wwerst/EE52/Rec_Feb28Notes.txt

Milestones for week:
1) DRAM PLD design and simulation
2) Schematic: Power circuitry
3) PCB: Power circuitry

Simulation:
1) Single read
2) single write
3) Back-to-back read or write
4) Refresh
5) 

10110111

10101000
