wwerst/EE52/Rec_Feb21Notes.txt

Milestones for week:
1) DRAM Timing (Read/Write/Refresh) (60 pts)
2) DRAM Schematic/PCB (40 pts)
3) Audio Software Diagram (30 pts)
