wwerst/EE52/Rec_Feb14Notes.txt

Milestones for week:
1) Timing: Audio
2) Block Diagram: DRAM
3) PCB: Audio, Ethernet

Audio timing:
TCLK freq,
