wwerst/EE52/Rec_Feb7Notes.txt

Milestones for week:
1) LCD Timing
2) Audio Schematic
3) Ethernet Schematic

cd600dp
wh2125a
