wwerst/EE52/WebPages/EE_CS 52 Project - ARM VoIP Telephone Software Interface Specification.html

# ARM VoIP Telephone Project Software Interface Specification (version 1)

## Function Descriptions

This document describes the interface between the software that will be supplied and the code that must be written. Since each system is different there must be a level of abstraction between the supplied software and the actual hardware. This document describes the functions, symbols, and data structures that implement that abstraction. Note that this document only describes the interface between the supplied software and the project's hardware and many more data structures and functions will exist in the code that implements the low-level hardware routines.

The supplied software should be called after all initialization is done. A function called main is defined globally. This function runs the system and will never return. The supplied code assumes the code section is called .text, and the data section is called .data.

For each part of the software system the symbols, data, and functions are given. The names must match exactly. The symbols should be defined by the implementor (student) in the file interfac.h. A template for this file is included in the distribution. The symbol values in the supplied file will need to be changed to match the implementation. The data and functions should be declared .global in the .s file in which they are defined. The functions must maintain the values of R4, R5, R6, R7, R8, R9, R10, R11, R12 (FP), R14 (LR), R15 (PC) and, of course, not mess with the stack pointer - R13 (SP).

## General

#### Symbols

DRAM_START | | starting address of the DRAM
MEMORY_SIZE | | number of IP addresses which can be stored in memory for later recall (typically 32)
SAMPLE_RATE | | number of audio samples per second (typically 8000)
MAC_ADDR_H | | upper 16-bits of the 48-bit MAC address for the ethernet controller
MAC_ADDR_L | | lower 32-bits of the 48-bit MAC address for the ethernet controller
ETHER_INTF | | the name of the ethernet interface to use (typically "et0")

#### Data

None

#### Functions

int elapsed_time(void)

Returns the number of milliseconds which have elapsed since the last time this function was called. Note that this may be zero if the function was recently called.

## Keypad/Switches

#### Symbols

KEY_0 | | keycode for the <0> key
KEY_1 | | keycode for the <1> key
KEY_2 | | keycode for the <2> key
KEY_3 | | keycode for the <3> key
KEY_4 | | keycode for the <4> key
KEY_5 | | keycode for the <5> key
KEY_6 | | keycode for the <6> key
KEY_7 | | keycode for the <7> key
KEY_8 | | keycode for the <8> key
KEY_9 | | keycode for the <9> key
KEY_ESC | | keycode for the <ESC> key
KEY_BACKSPACE | | keycode for the <Backspace> key
KEY_SEND | | keycode for the <Send> key
KEY_OFFHOOK | | keycode for the <Off Hook> key
KEY_ONHOOK | | keycode for the <On Hook> key
KEY_SET_IP | | keycode for the <Set IP> key
KEY_SET_SUBNET | | keycode for the <Set Subnet> key
KEY_SET_GATEWAY | | keycode for the <Set Gateway> key
KEY_MEM_SAVE | | keycode for the <Memory Save> key
KEY_MEM_RECALL | | keycode for the <Memory Recall> key
KEY_ILLEGAL | | illegal keycode, different from any valid keycode

#### Data

None

#### Functions

unsigned char key_available(void)

Returns TRUE (non-zero) if there is a valid key ready to be processed and FALSE (zero) otherwise.

int getkey(void)

Returns the keycode (as defined above (http://wolverine.caltech.edu/eecs52/projects/armvoip/swispec.htm#KeySymbols)) for the debounced key. This value must never be KEY_ILLEGAL (http://wolverine.caltech.edu/eecs52/projects/armvoip/swispec.htm#KEY_ILLEGAL). The function does not return until it has a valid key.

## Display

#### Symbols

STATUS_IDLE | | current status (for display) is Idle
STATUS_OFFHOOK | | current status (for display) is Off Hook
STATUS_RINGING | | current status (for display) is Ringing
STATUS_CONNECTING | | current status (for display) is Connecting
STATUS_CONNECTED | | current status (for display) is Connected
STATUS_SET_IP | | current status (for display) is Set IP
STATUS_SET_SUBNET | | current status (for display) is Set Subnet
STATUS_SET_GATEWAY | | current status (for display) is Set Gateway
STATUS_MEM_SAVE | | current status (for display) is Memory Save
STATUS_MEM_RECALL | | current status (for display) is Memory Recall
STATUS_RECALLED | | current status is a memory address was just recalled, otherwise status is like Idle
STATUS_ILLEGAL | | illegal status, different from any valid status

#### Data

None

#### Functions

void display_IP(unsigned long int)

Displays the passed IP address on the LCD/LED display. The passed IP address is in binary.

void display_memory_addr(unsigned int)

Displays the passed memory address on the LCD/LED display. The passed memory address is in binary and will range from 1 to MEMORY_SIZE (http://wolverine.caltech.edu/eecs52/projects/armvoip/swispec.htm#MEMORYSIZE).

void display_status(unsigned int)

Displays the passed status (as described above (http://wolverine.caltech.edu/eecs52/projects/armvoip/swispec.htm#StatusSymbols)) on the LCD/LED display. Note that some status values may also cause tones or other sounds to be output. The passed status will never be STATUS_ILLEGAL (http://wolverine.caltech.edu/eecs52/projects/armvoip/swispec.htm#STATUS_ILLEGAL).

## Audio Circuitry

#### Symbols

AUDIO_BUFLEN | | length of each audio buffer This symbol specifies the size of the buffers used for audio input and output.

#### Data

None

#### Functions

void call_start(short int *)

Begins recording the microphone data into the passed buffer (of length AUDIO_BUFLEN (http://wolverine.caltech.edu/eecs52/projects/armvoip/swispec.htm#AUDIOBUFLEN)). The first argument points to the first buffer in DRAM to be filled with data. Note that the actual storing of data is done under interrupt control and this function should return immediately after setting up for the call. After this function is called and the call has begun all future buffers for audio data will be supplied using the update_rx (http://wolverine.caltech.edu/eecs52/projects/armvoip/swispec.htm#updateRX) and update_tx (http://wolverine.caltech.edu/eecs52/projects/armvoip/swispec.htm#updateTX) functions. Note that an initial output buffer is not passed (the call has just started so there isn't one as yet).

void call_halt(void)

Immediately halts audio transmitting and receiving for the call.

unsigned char update_rx(short int *)

Returns TRUE (non-zero) if an update was needed and the passed pointer was used (meaning the pointer was stored and the buffer will be recorded into by the user's code). FALSE (zero) should be returned if the audio input routines have not finished filling either of the buffers they already have. The passed pointer indicates the next buffer (of length AUDIO_BUFLEN (http://wolverine.caltech.edu/eecs52/projects/armvoip/swispec.htm#AUDIOBUFLEN)) to be filled. If TRUE is returned another buffer will be allocated for recording and its address will be passed to update_rx the next time it is called. If FALSE is returned then the software assumes the buffer was not used and will pass the same buffer pointer on the next call to update_rx. The supplied software also assumes that the data is double buffered. That is, it assumes the user code has two buffer pointers stored, the one currently being recorded to and the next one to be recorded to.

unsigned char update_tx(short int *)

Returns TRUE (non-zero) if an update was needed and the passed pointer was used (meaning the pointer was stored and the buffer data will be played by the user's code). FALSE (zero) should be returned if the audio output routines are not ready for more data. The passed pointer indicates the next buffer (of length AUDIO_BUFLEN (http://wolverine.caltech.edu/eecs52/projects/armvoip/swispec.htm#AUDIOBUFLEN)) to be played. When TRUE is returned another buffer will be retrieved from DRAM (where it was put by the networking routines) for the next call to update_tx. If FALSE is returned then the software assumes the buffer was not used and will pass the same buffer pointer on the next call to update_tx. The supplied software also assumes that the data is double buffered. That is, it assumes the user code has two buffer pointers stored, the one currently being played from and the next one to be played from.

## Ethernet

#### Symbols

None

#### Data

None

#### Functions

char ether_init()

Initializes the ethernet interface. This function does all of the low-level initialization for the ethernet interface. After it returns the ethernet interface is ready for use. The function returns TRUE (non-zero) if there is no error initializing the interface and FALSE (zero) if there is an error.

char ether_transmit(struct pbuf *)

Transmits the packet pointed to by the passed pbuf chain over the ethernet interface. The argument points to the first pbuf in the chain. Note that there could be more than one pbuf in the chain. The function returns TRUE (non-zero) if there is no error and FALSE (zero) if there is an error.

char ether_rx_available()

Returns TRUE (non-zero) if there is received ethernet data available and FALSE (zero) otherwise.

struct pbuf *ether_receive()

Returns a pointer to the start of a pbuf chain containing a received internet packet. If there is no ethernet data currently available, the function returns NULL. If there is data available a chain of pbuf buffers is filled with the received data. Note that the function pbuf_alloc must be called in this function in order to get a pbuf chain for storing the data.

Last updated February 03, 2016 by glen@caltech.edu

copyright � 2006 - 2016, Glen George. All rights reserved. Reproduction of all or part of this work is permitted for educational or research use only, provided that this copyright notice is included in any copy.
