wwerst/EE52/SoftwareDiagrams.pdf

2/5/2017 | Preview

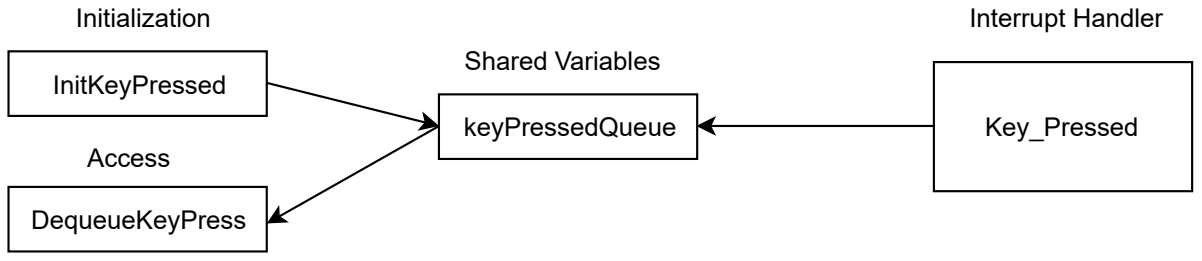
[picture p25: figure]
Key_Pressed; Interrupt Handler; keyPressedQueue; Shared Variables; InitKeyPressed; Initialization; DequeueKeyPress; Access

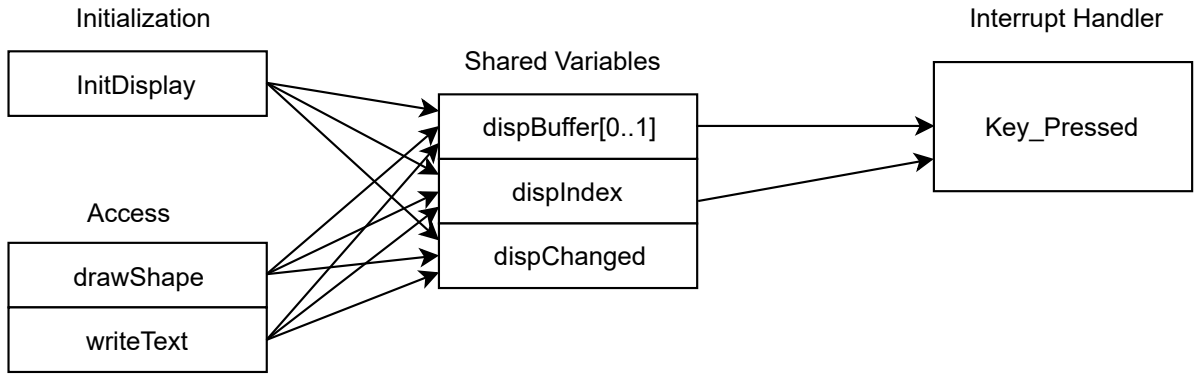
[picture p26: figure]
Key_Pressed; Interrupt Handler; dispBuffer[0..1]; Shared Variables; InitDisplay; Initialization; drawShape; Access; dispIndex; writeText; dispChanged
