wwerst/EE52/TimingDiagrams/SRAM_Write.pdf

# SRAM_WRITE

## CLK

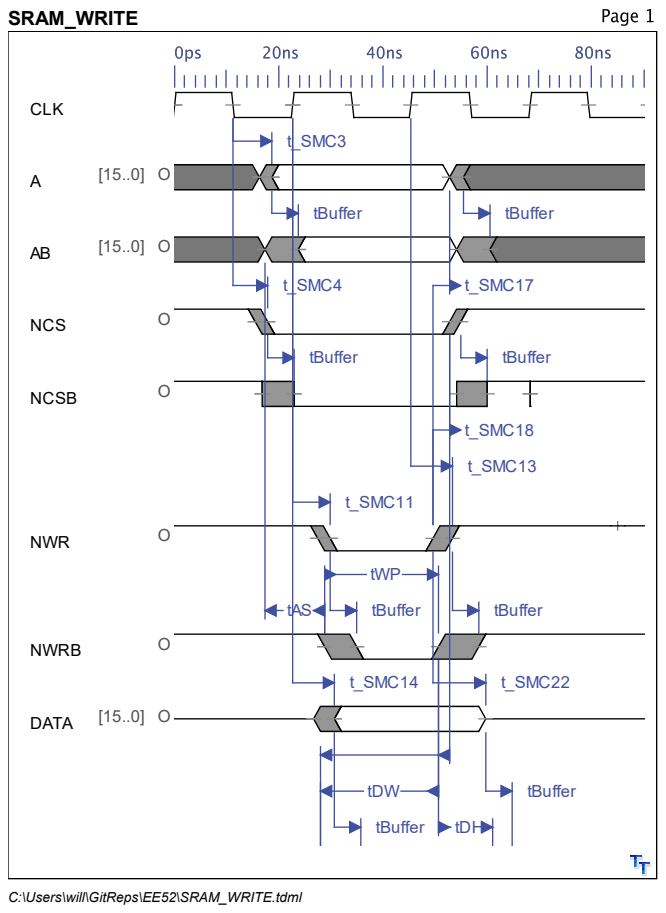
[picture p28: page 1]
NCS; NCSB; NWR; NWRB; DATA; t_SMC3; tBuffer; t_SMC4; t_SMC14; t_SMC11; t_SMC13; t_SMC22; tWP; tAS; tDW; tDH; t_SMC17; t_SMC18

C:\Users\will\GitReps\EE52\SRAM_WRITE.tdml

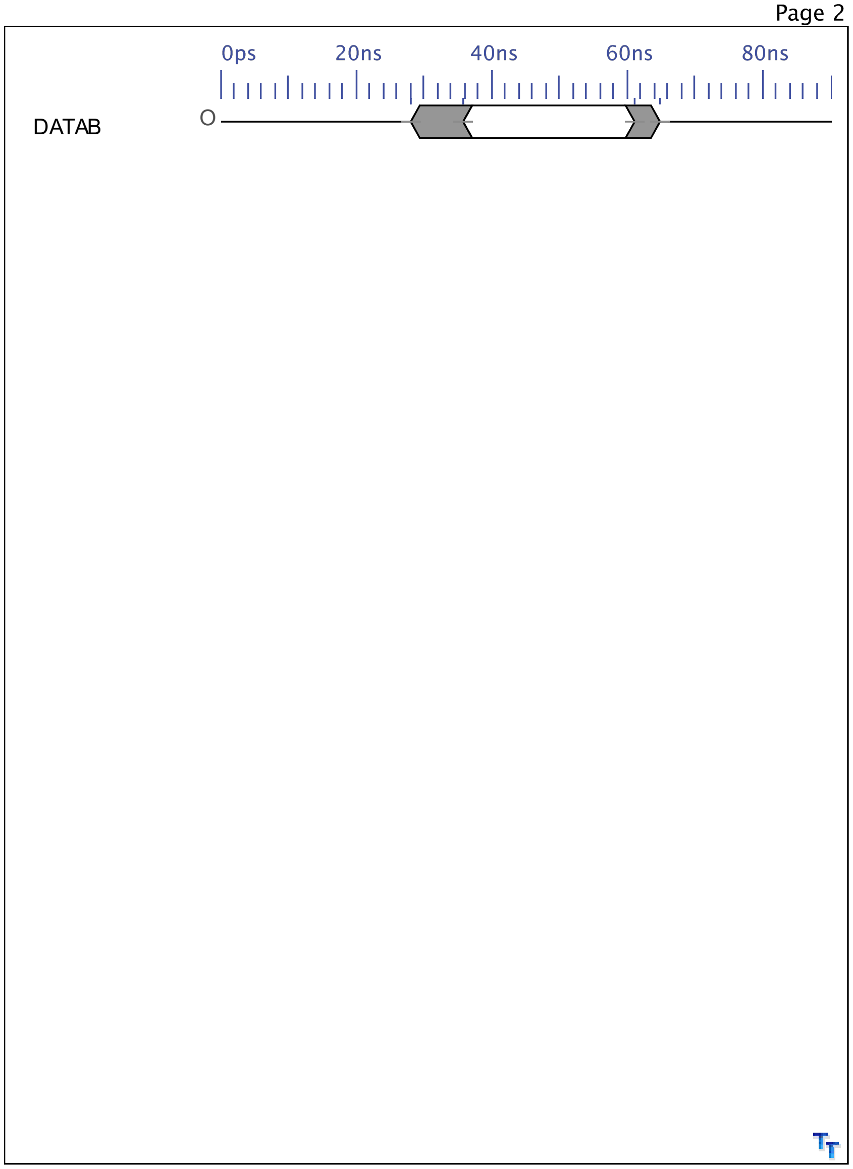
[picture p29: figure]
DATAB

General Data

SYMBOL | DEFINITION | DESCRIPTION | MIN | MAX | NOTES
t_SMC3 | MCK Falling to A1-A25 valid | to be defined | 4.9ns | 7.5ns
tBuffer | | to be defined | 1.3ns | 5.1ns
t_SMC14 | MCK Rising to D0-D15 Valid | to be defined | 4.1ns | 7.9ns
t_SMC4 | MCK falling to CHip Select Change | to be defined | 4.3ns | 6.5ns
tAS | Address Setup to End of Write | to be defined | 0ns
tDW | Data Setup Time | to be defined | 9ns
tDH | Data Hold Time | to be defined | 0ns
tWR | Address Hold from End of Write | to be defined | 0ns
tWP | Write Pulse | to be defined | 12ns
t_SMC11 | MCK Rising to NWR Active (with wait states)
to be defined | 4.8ns | 7.2ns
t_SMC13 | MCK Rising to
NWR Inactive
to be defined | 4.1ns | 7.9ns
t_SMC22 | MCK Rising to
Data Out Invalid
to be defined | 10.2ns
t_SMC17 | NWR High to
A1-A25 Change
to be defined | 3.3ns
t_SMC18 | NWR High to
Chip Select
Inactive

to be defined 3.3ns

Notes:

Results:

### 0 setup 1 wait state (pulse length) 0 hold parameter
