wwerst/EE52/Documentation/PrintedCode/keypad.s.pdf

C:\Users\will\Documents\GitHub\EE52\Code\src\sys\keypad.s | Monday, December 4, 2017 8:36 AM

## @ Shared variables: LastKeypress - initialized to KEY_ILLEGAL

-1-
