wwerst/EE52/Documentation/PrintedCode/pio.s.pdf

C:\Users\will\Documents\GitHub\EE52\Code\src\sys\pio.s | Monday, December 4, 2017 8:37 AM

## @ Name Comment Date @ Will Werst Initial version 6/22/2017

-1-
