wwerst/EE52/TimingDiagrams/Audio.pdf

# AUDIO

PCMI | O

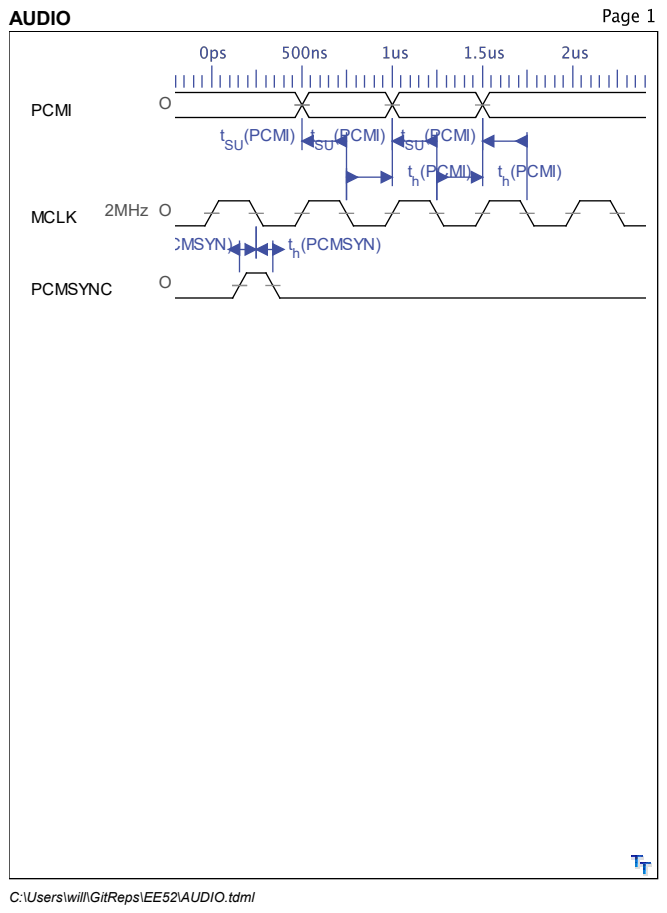
[picture p35: page 1]
MCLK; 2MHz O; PCMSYNC; MSYN); (PCMSYN); tSU(PCMI); (PCMI)

C:\Users\will\GitReps\EE52\AUDIO.tdml

General Data

SYMBOL | DEFINITION | DESCRIPTION | MIN | MAX | NOTES
tSU(PCMSYN) | Setup time, PCMSYN high before MCLK low | to be defined | 20ns | 480ns

t
h
(PCMSYN) | Hold time,
PCMSYN high
after MCLK low
to be defined | 20ns | 480ns
tSU(PCMI) | Setup time,
PCMI high or low
before MCLK low

to be defined 20ns

t
h
(PCMI) | Hold time, PCMI
high or low after
MCLK low

to be defined 20ns

Notes:

MCLK = 2 MHz (can't get 2.048 MHz) Divider ratio on AT91RM9200 = 11 Frame sync period = 128us
Frame sync length = 256 bits
