wwerst/EE52/Altium/VoIP/Main.pdf

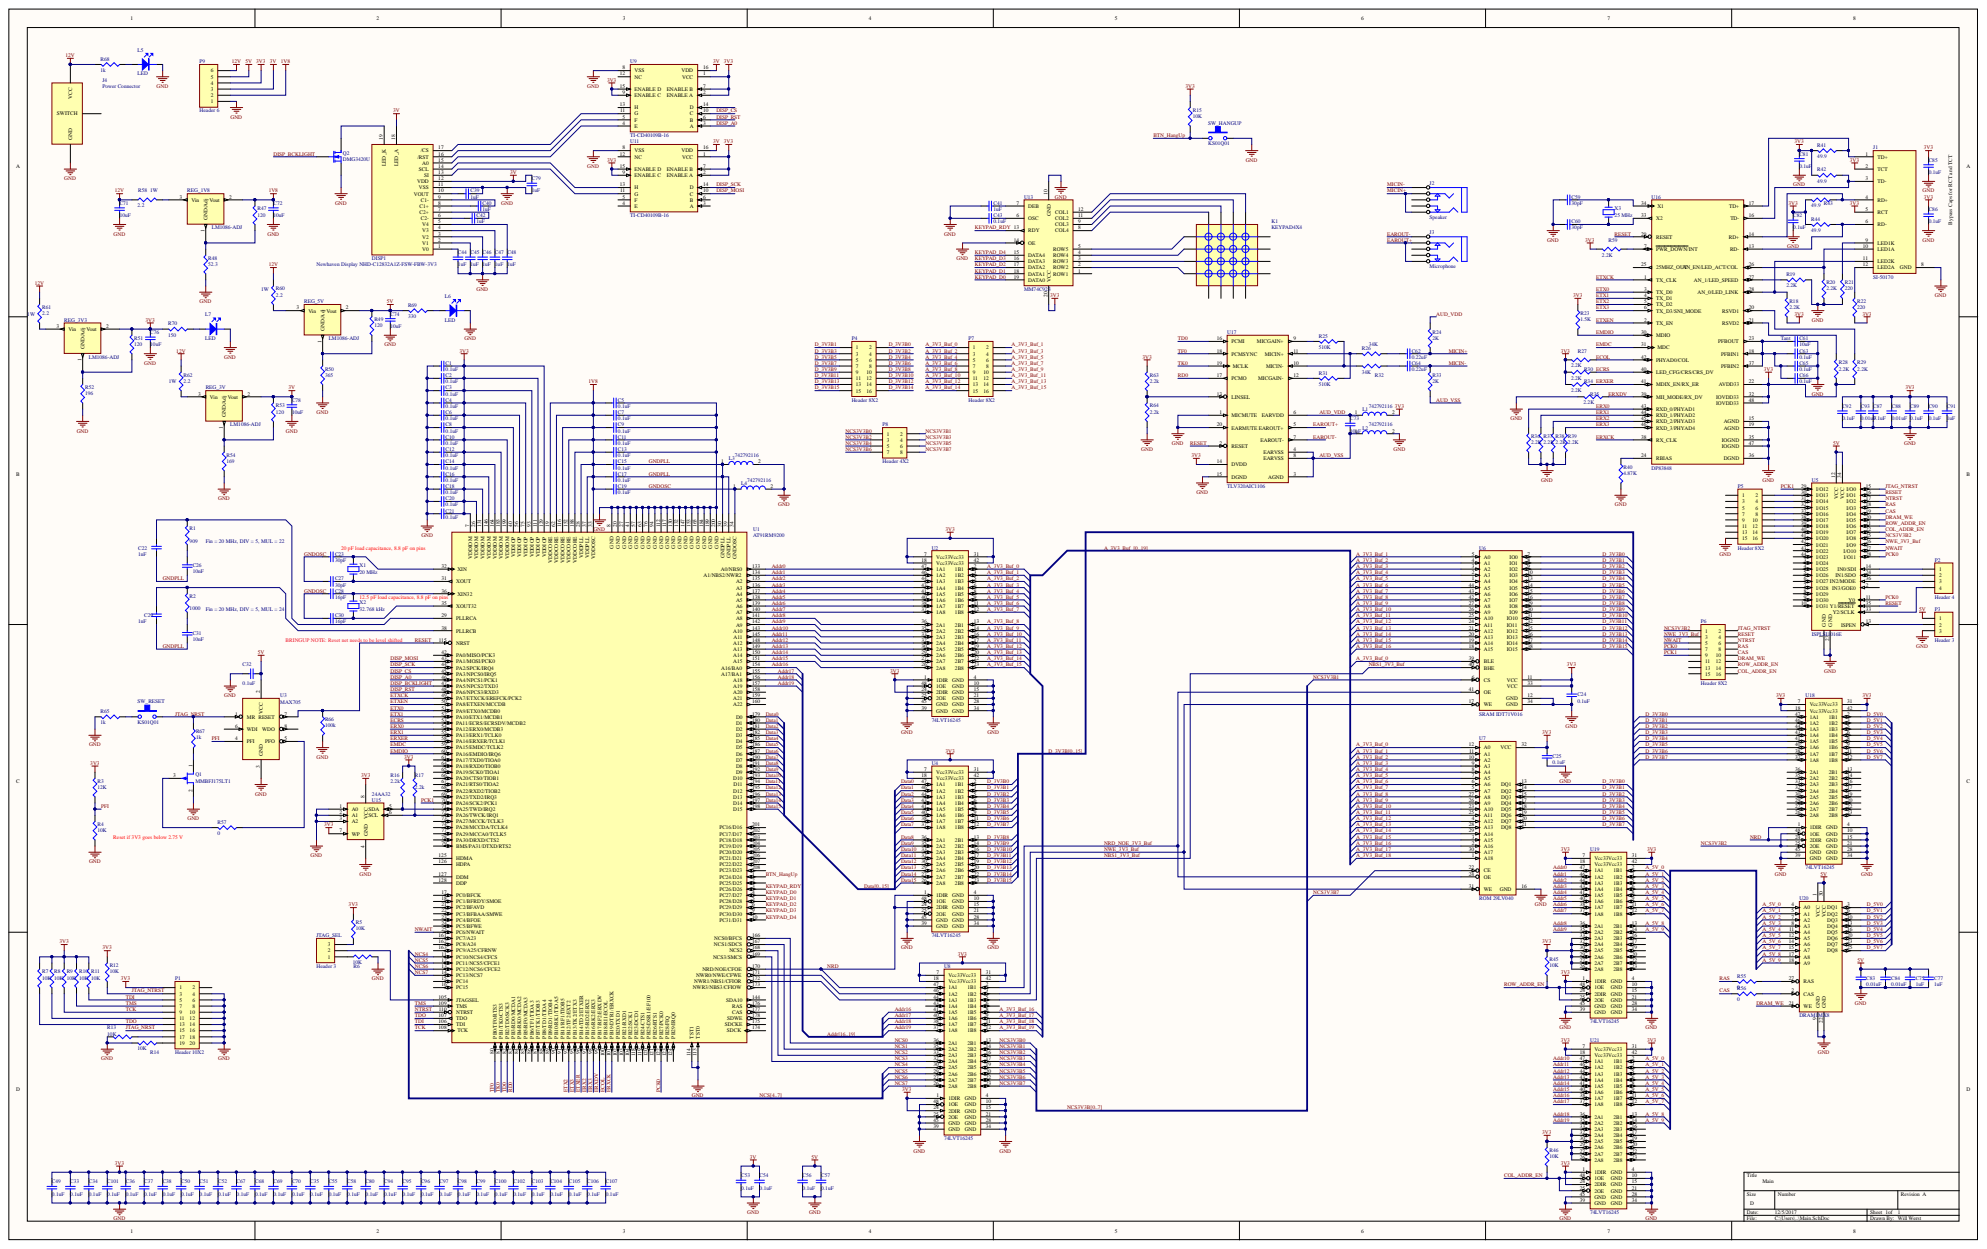
[picture p36: page 1]

Bypass Caps for RCT and TCT

Newhaven Display NHD-C12832A1Z-FSW-FBW-3V3

Fin = 20 MHz, DIV = 5, MUL = 22

20 pF load capacitance, 8.8 pF on pins

Fin = 20 MHz, DIV = 5, MUL = 24

12.5 pF load capacitance, 8.8 pF on pins
32.768 kHz

BRINGUP NOTE: Reset net needs to be level shifted

Reset if 3V3 goes below 2.75 V

1 2 3 4 5 6 7 | File: C:\Users\..\Main.SchDoc 8 | Drawn By: Will Werst

# Board S
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
