wwerst/EE52/Altium/VoIP/PCB.pdf

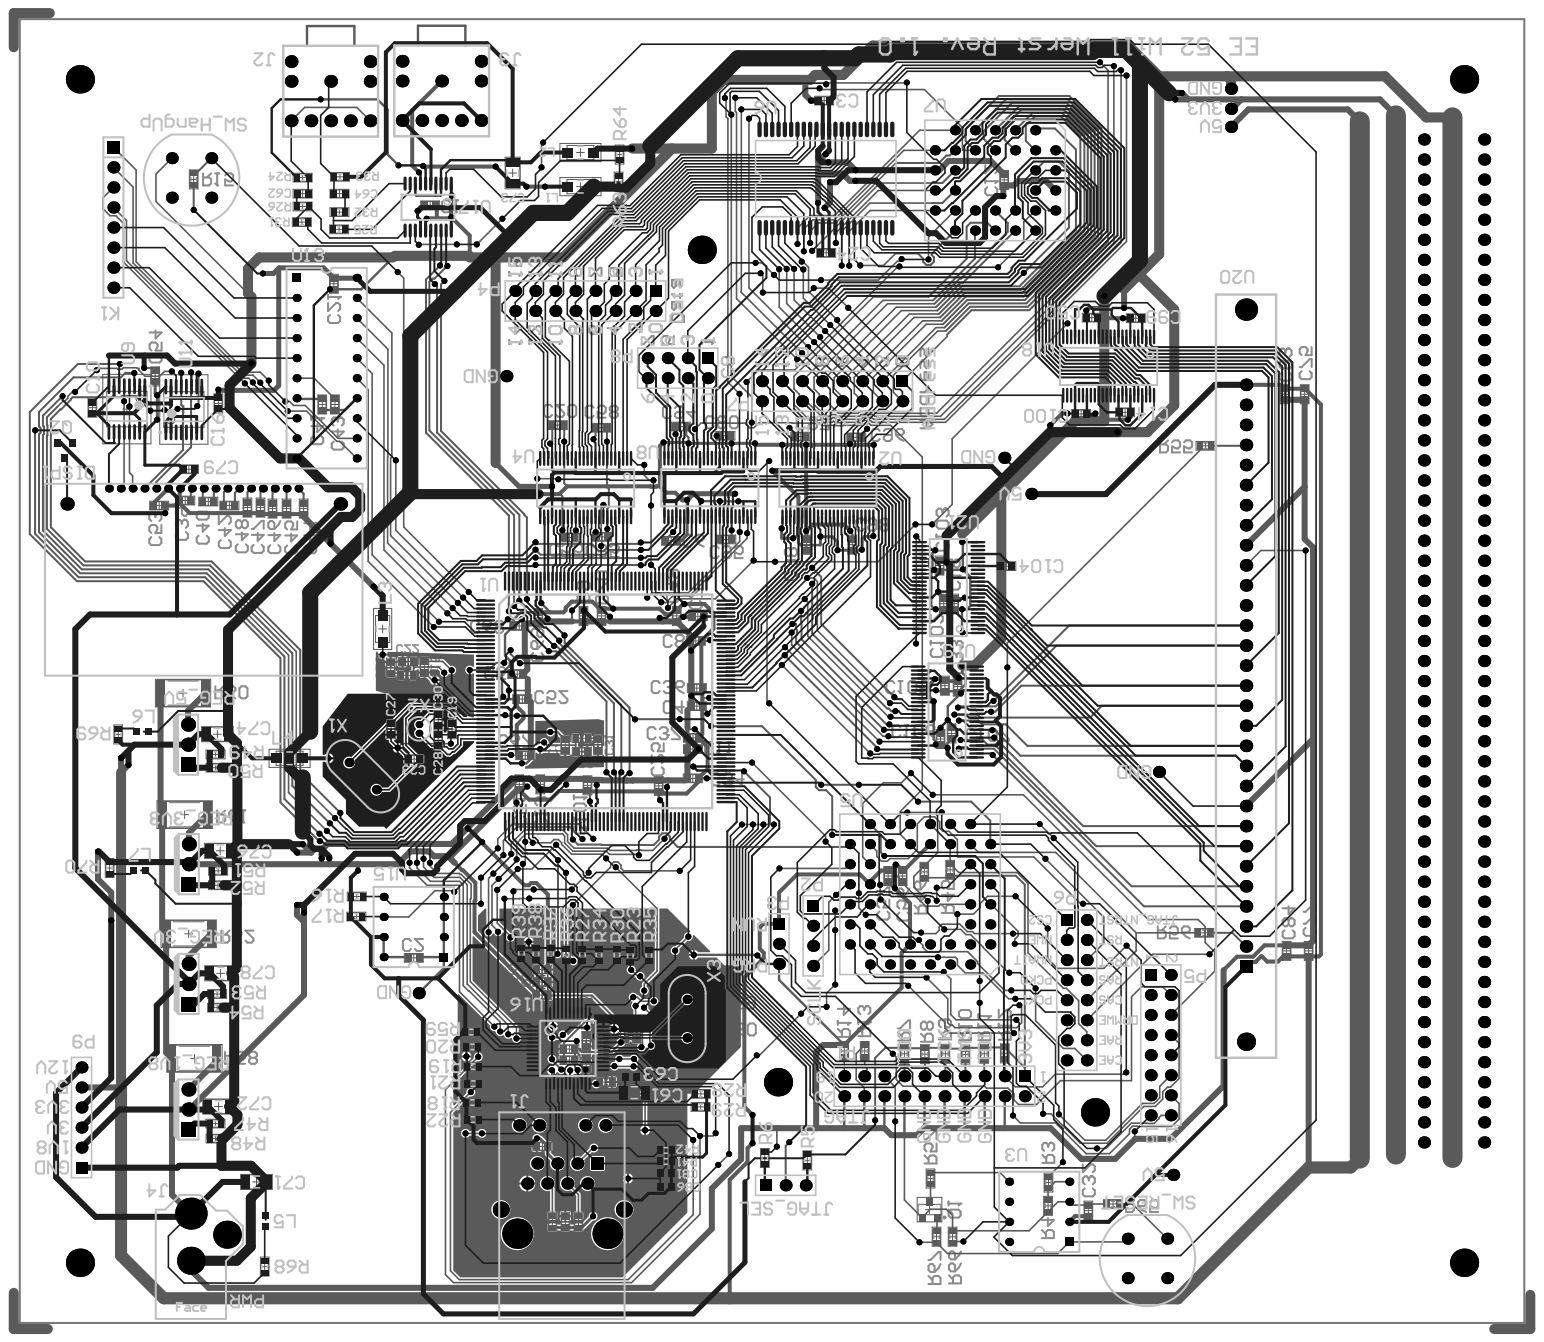
[picture p37: page 1]

Board S
