wwerst/EE52/Schematic Prints.pdf

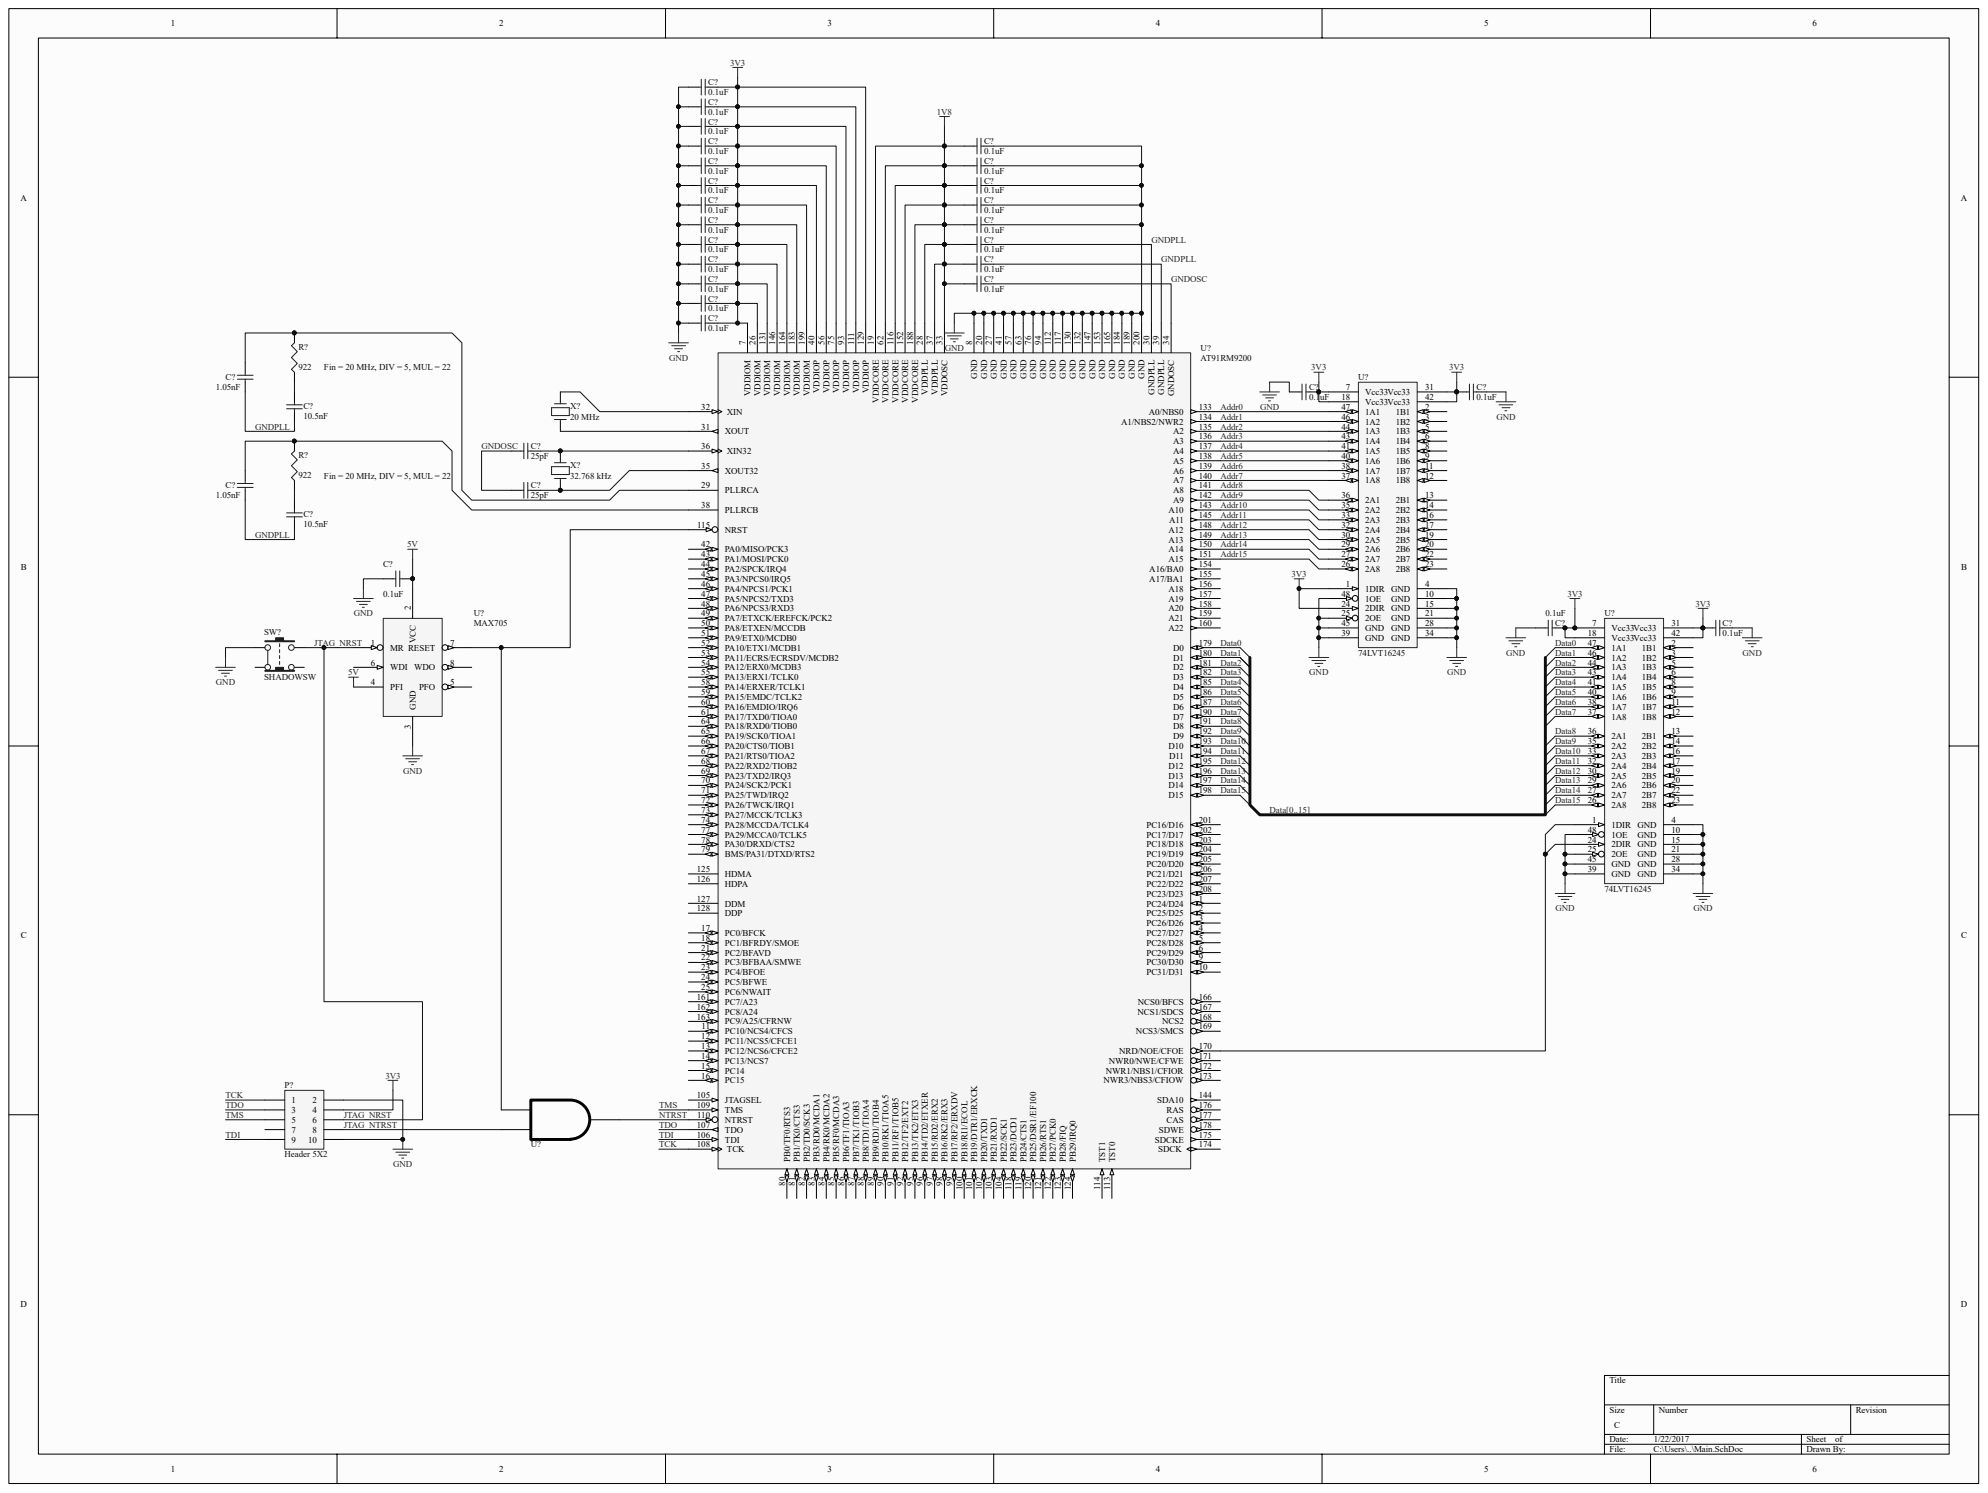
[picture p38: page 1]

Fin = 20 MHz, DIV = 5, MUL = 22

Size C | Number | Revision

Date: 1/22/2017 | Sheet of
File: C:\Users\..\Main.SchDoc | Drawn By:
