wwerst/EE52/BoardLayout.pdf

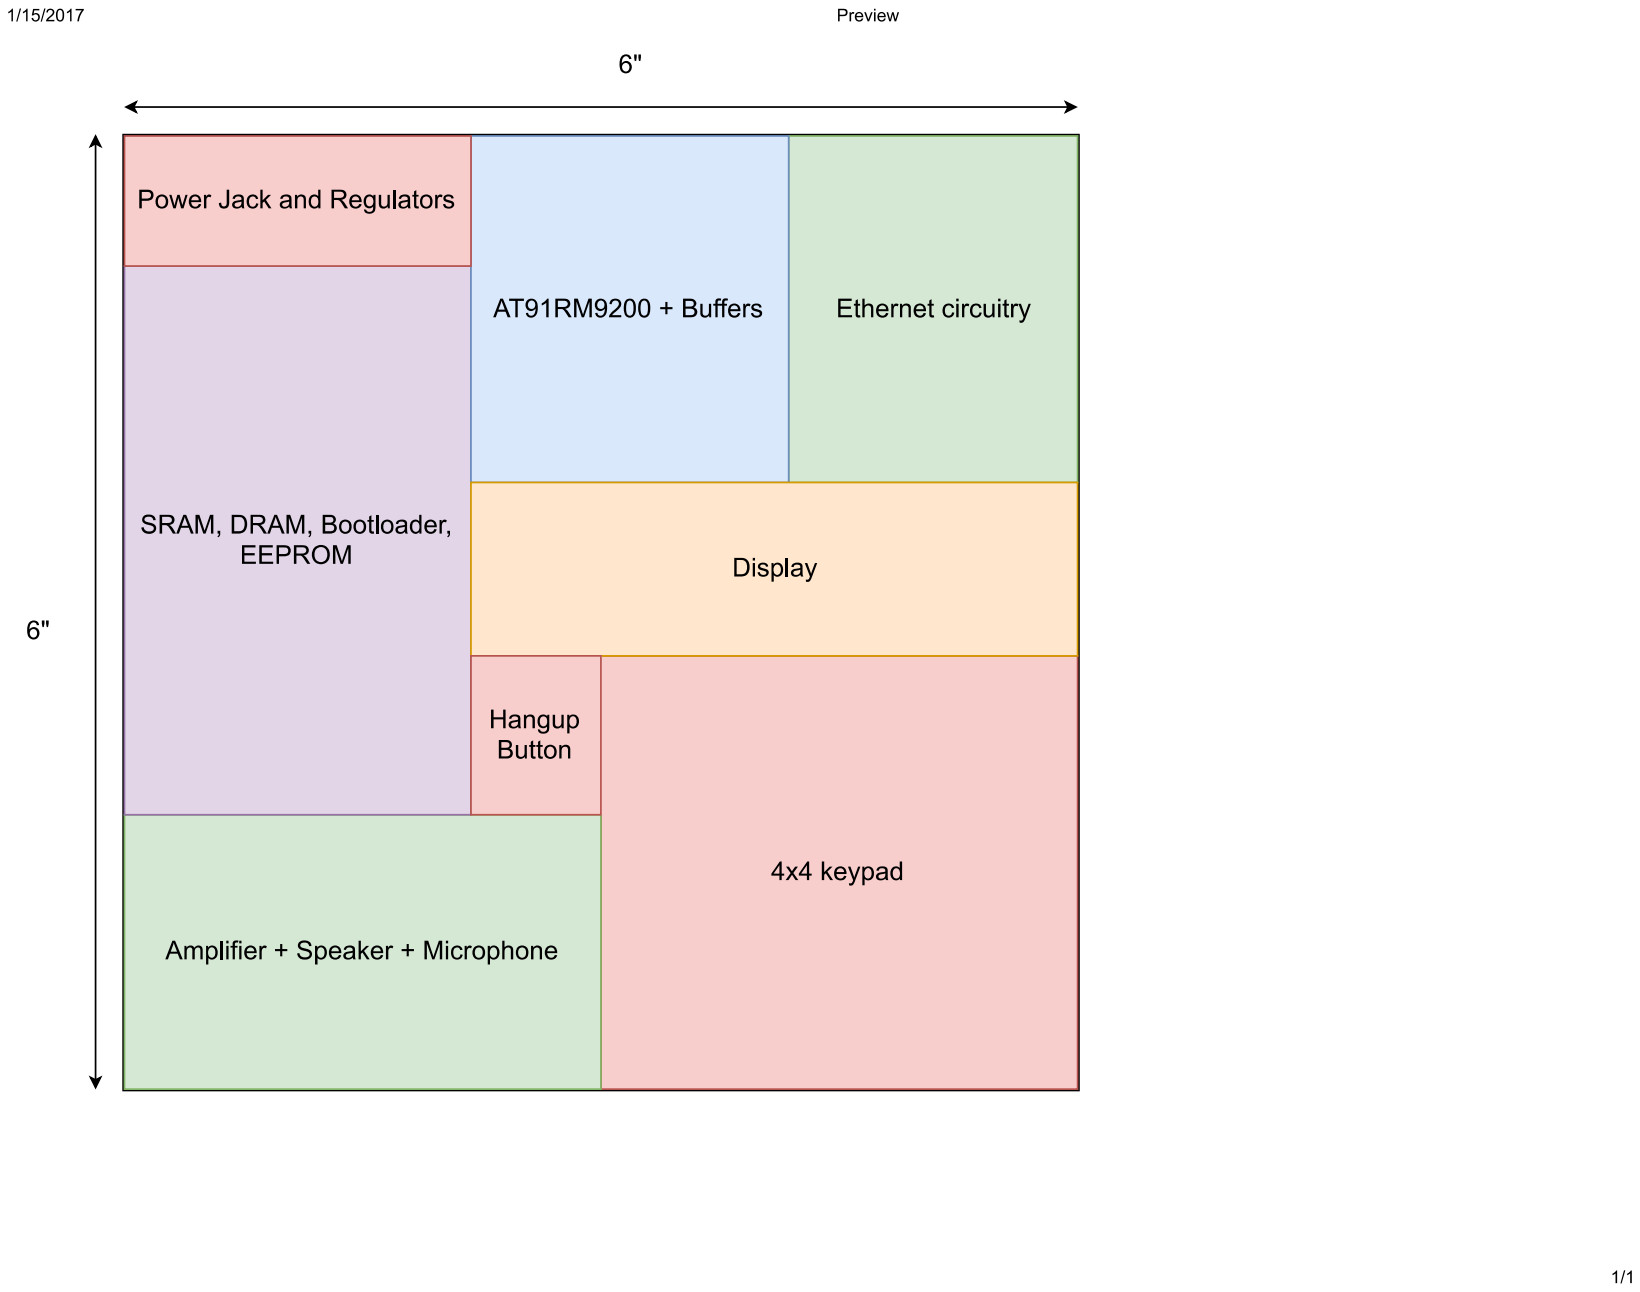
[picture p39: page 1]
