wwerst/EE52/TimingDiagrams/Rom_Read.pdf

# ROM_READ

## CLK

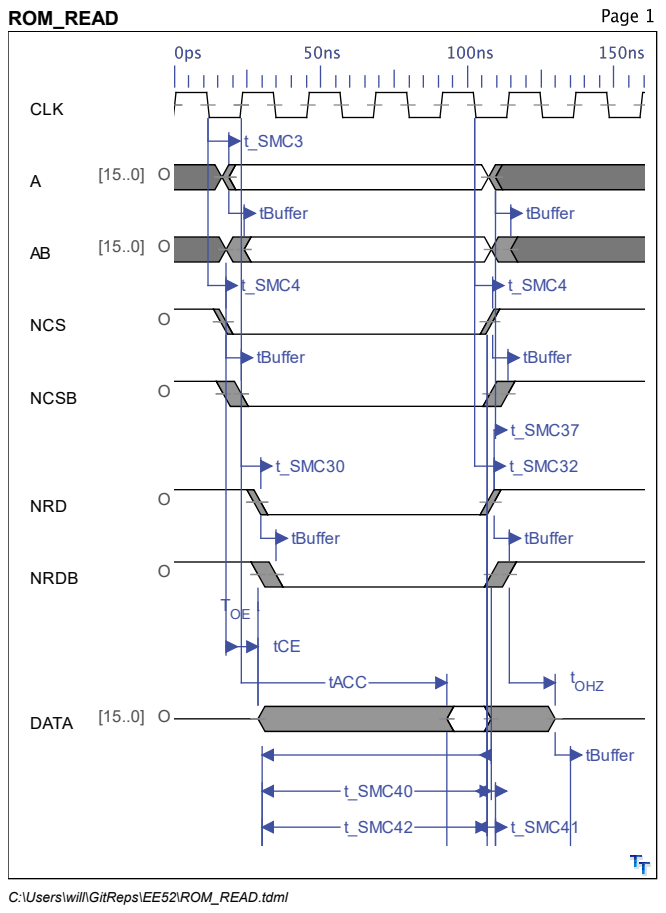
[picture p40: page 1]
NCS; NCSB; NRD; NRDB; DATA; t_SMC4; t_SMC3; tBuffer; t_SMC30; tACC; TOE; tCE; t_SMC32; tOHZ; t_SMC41; t_SMC37; t_SMC40; t_SMC42

C:\Users\will\GitReps\EE52\ROM_READ.tdml

## DATAB

O

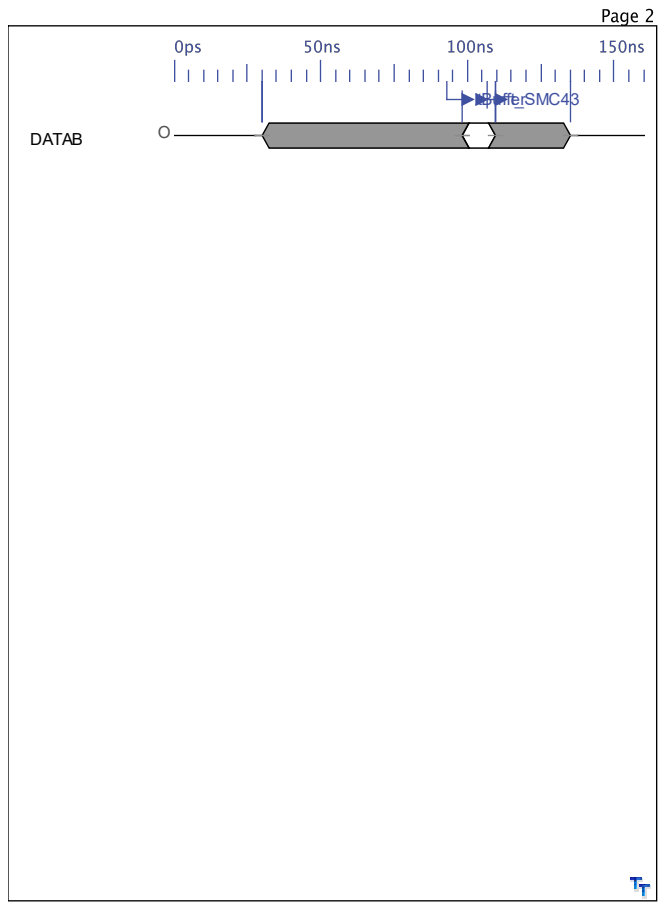
[picture p41: page 2]
tBuffer t_SMC43

General Data

SYMBOL | DEFINITION | DESCRIPTION | MIN | MAX | NOTES
t_SMC3 | MCK Falling to A1-A25 valid | to be defined | 4.9ns | 7.5ns
t_SMC4 | MCK Falling to Chip Select | to be defined | 4.3ns | 6.5ns
tBuffer | | to be defined | 1.3ns | 5.1ns
t_SMC1 | | to be defined
t_SMC30 | MCK Rising to NRD Active | to be defined | 4.7ns | 7.0ns
tACC | Address Access time | defined by memory | 0ps | 70ns
tCE | Chip Select Access time | defined by memory | 0ns | 70ns
TOE | Output enable access time | defined by memory | 0ns | 30ns
t_SMC32 | | to be defined | 4.5ns | 6.8ns
t_SMC40 | Data Setup time before NRD | to be defined | 7.5ns
t_SMC4 | MCK falling to CHip Select Change | to be defined | 4.3ns | 6.5ns
t_SMC41 | Data Hold time
after NRD rising
to be defined | -3.4ns
t_SMC37 | NRD High to
A1-A25 change
to be defined | 0.3ns | 0.6ns
tOHZ | Output Enable
High to Output in
High-Z
defined by memory | 0ns | 16ns
t_SMC42 | Data Setup
before NCS High
to be defined | 7.3ns
t_SMC43 | Data Hold after
NCS High

to be defined -3.2ns

Notes:

Device: AM29LV040

Results:

### 1 wait states
