wwerst/EE52/TimingDiagrams/Rom_Write.pdf

# ROM_WRITE

## CLK

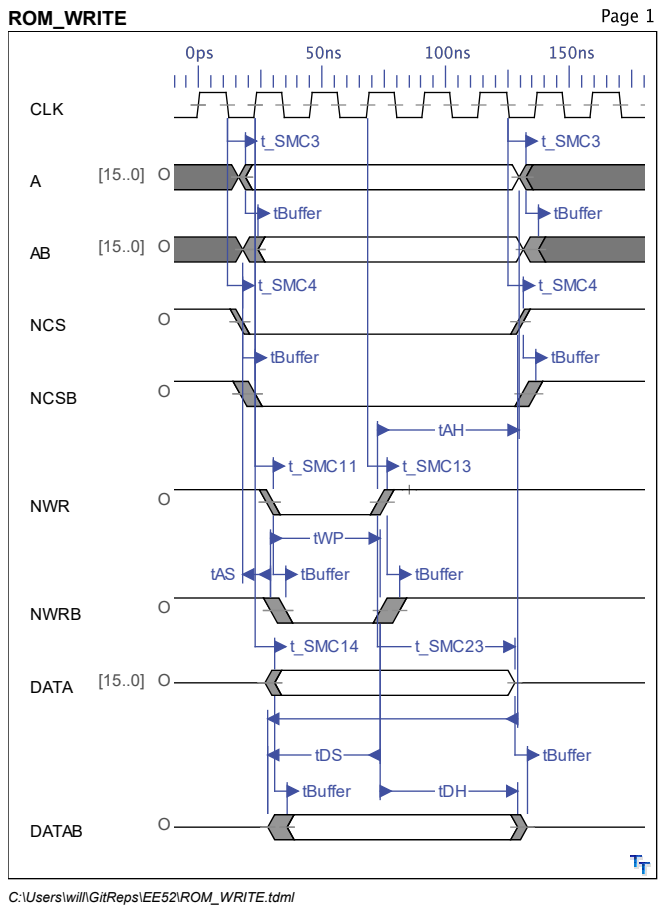
[picture p42: page 1]
NCS; NCSB; NWR; NWRB; DATA; DATAB; t_SMC3; tBuffer; t_SMC4; t_SMC14; t_SMC11; t_SMC23; tWP; tAS; tDS; tDH; t_SMC13; tAH

C:\Users\will\GitReps\EE52\ROM_WRITE.tdml

General Data

SYMBOL | DEFINITION | DESCRIPTION | MIN | MAX | NOTES
t_SMC3 | MCK Falling to A1-A25 valid | to be defined | 4.9ns | 7.5ns
tBuffer | | to be defined | 1.3ns | 5.1ns
t_SMC14 | MCK Rising to D0-D15 Valid | to be defined | 4.1ns | 7.9ns
t_SMC4 | MCK falling to CHip Select Change | to be defined | 4.3ns | 6.5ns
tAS | Address Setup to End of Write | to be defined | 0ns
tDS | Data Setup Time | to be defined | 35ns
tDH | Data Hold Time | to be defined | 0ns
tAH | Address Hold from End of Write | to be defined | 45ns
tWP | Write Pulse | to be defined | 35ns
t_SMC11 | MCK Rising to NWR Active (with wait states)
to be defined | 4.8ns | 7.2ns
t_SMC13 | MCK Rising to
NWR Inactive
to be defined | 4.1ns | 7.9ns
t_SMC23 | MCK Rising to
Data Out Invalid
(1 hold state)
to be defined | 55.7ns
t_SMC17 | NWR High to
A1-A25 Change

to be defined 3.3ns

Notes:

Results:

### 0 setup 2 wait state (pulse length) 2.5 hold parameter
