wwerst/EE52/(list of files, drawings)

Other design files:
Altium/08EB8267-D17E-4CFC-99BC-5B4E19CA83B1_TI-CD40109B-16.SchLib
Altium/CD40109.PcbLib
Altium/CD40109.SchLib
Altium/Display-NHD-C12832.PcbLib
Altium/Display-NHD-C12832.SchLib
Altium/eecs5x.PcbLib
Altium/EEW_Client.PcbLib
Altium/EEW_Client.SchLib
Altium/F740E987-1FCD-4EA6-8A27-F2C7C68DFF6A_TI-PW16_M.PcbLib
Altium/screwire.PcbLib
Altium/VoIP/CustomParts.PcbLib
Altium/VoIP/CustomParts.SchLib
Altium/VoIP/Main.SchDoc
Altium/VoIP/PCB.PcbDoc
Altium/VoIP/VoIP.PrjPcb
