wwerst/EE52/(commit log)

2017-01-22 start of week 2
    [eecs5x.PcbLib]
2017-01-22 2nd week part done
    [Main.SchDoc, VoIP.PrjPcb, screwire.PcbLib]
2017-01-23 2nd week check in prior to meeting
    [CustomParts.SchLib, Main.SchDoc, VoIP.PrjPcb]
2017-01-24 2nd week before revisions
    [Main.SchDoc]
2017-01-30 changes week 2
    [Main.SchDoc, PCB.PcbDoc, VoIP.PrjPcb]
2017-01-31 week 3
    [Main.SchDoc, PCB.PcbDoc, VoIP.PrjPcb]
2017-02-01 added eeprom
    [Main.SchDoc, PCB.PcbDoc]
2017-02-06 altium week 4 done
    [08EB8267-D17E-4CFC-99BC-5B4E19CA83B1_TI-CD40109B-16.SchLib, CD40109.PcbLib, CD40109.SchLib, Display-NHD-C12832.PcbLib, Display-NHD-C12832.SchLib, EEW_Client.PcbLib, EEW_Client.SchLib, F740E987-1FCD-4EA6-8A27-F2C7C68DFF6A_TI-PW16_M.PcbLib]
2017-02-13 week 5
    [Main.SchDoc]
2017-02-13 done with schematic
    [Main.SchDoc, PCB.PcbDoc]
2017-02-13 such autorouting
    [Main.SchDoc, PCB.PcbDoc, VoIP.PrjPcb]
2017-02-13 Week 5 finished
    [Main.SchDoc]
2017-02-20 DRAM block diagram and pcb route done
    [Main.SchDoc, PCB.PcbDoc]
2017-02-20 maybe done with timing diagrams
    [Main.SchDoc]
2017-02-28 going to meeting
    [Main.SchDoc, PCB.PcbDoc]
2017-03-02 week's changes
    [Main.SchDoc, PCB.PcbDoc]
2017-03-05 power circuitry
    [Main.SchDoc, PCB.PcbDoc]
2017-03-06 power circuitry done
    [PCB.PcbDoc]
2017-03-09 timing finished
    [PCB.PcbDoc]
2017-03-10 dram abel
    [Main.SchDoc]
2017-03-10 pre-autoroute, move display
    [Main.SchDoc, PCB.PcbDoc]
2017-03-11 Submitted to freedfm
    [Main.SchDoc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]
2017-03-12 Layout done
    [Main.SchDoc, PCB.PcbDoc, VoIP.PrjPcb]
2017-03-12 Pre-autoroute take 3
    [PCB.GBL, PCB.GBO, PCB.GBP, PCB.GBS, PCB.GKO, PCB.GM1, PCB.GTL, PCB.GTO]
2017-03-13 Passes FreeDFM
    [Main.SchDoc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]
2017-03-13 Tried to title the schematic.
    [Main.SchDoc, VoIP.PrjPcb]
2017-03-13 Week 9 done
    [Main.SchDoc, PCB.PcbDoc, VoIP.PrjPcb, VoIP.xlsx]
2017-03-14 PCB layout
    [Main.SchDoc, PCB.PcbDoc, VoIP.xlsx]
2017-03-18 Layout changes
    [Main.SchDoc, PCB.PcbDoc, VoIP.PrjPcb, VoIP.xlsx]
2017-03-23 Lots of routing
    [CustomParts.PcbLib, CustomParts.SchLib, EEW_Client.SchLib, Main.SchDoc, PCB.PcbDoc, VoIP.PrjPcb]
2017-03-23 Almost done
    [PCB.PcbDoc]
2017-03-24 Last signals left to route
    [PCB.PcbDoc]
2017-03-24 All but reset routed
    [PCB.PcbDoc]
2017-03-24 All done except cpld breakout
    [Main.SchDoc, PCB.PcbDoc]
2017-03-24 Sent to glen
    [PCB.GBL, PCB.GBO, PCB.GBP, PCB.GBS, PCB.GKO, PCB.GM1, PCB.GTL, PCB.GTO]
2017-03-30 2nd version almost done
    [EEW_Client.PcbLib, EEW_Client.SchLib, Main.SchDoc, PCB.PcbDoc, VoIP.PrjPcb]
2017-03-30 2nd version submitted
    [Main.SchDoc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]
2017-04-03 Version 3 submitting to glen
    [PCB.PcbDoc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]
2017-04-08 Almost done with revisions
    [PCB.PcbDoc]
2017-04-12 Pcbway export
    [PCB.GBL, PCB.GBO, PCB.GBP, PCB.GBS, PCB.GKO, PCB.GM1, PCB.GTL, PCB.GTO]
2017-06-13 issues with interrupts
2017-06-18 pld code for dram is closer to working but still has issues
    [pld.sdf]
2017-06-18 changes to code, done working on dram for now, will implement refresh with timer interrupt
2017-06-19 DRAM works without refresh, if ran at 11 MHz
    [pld.sdf]
2017-06-22 Working on display driver
2017-06-22 Writing display driver still
2017-06-23 Commit before changing display data transfer to be interrupt driven, no DMA
2017-06-23 switching computers
